GeoEduLab/Slinky-Seismometer/images/SlinkyRender1.PNG

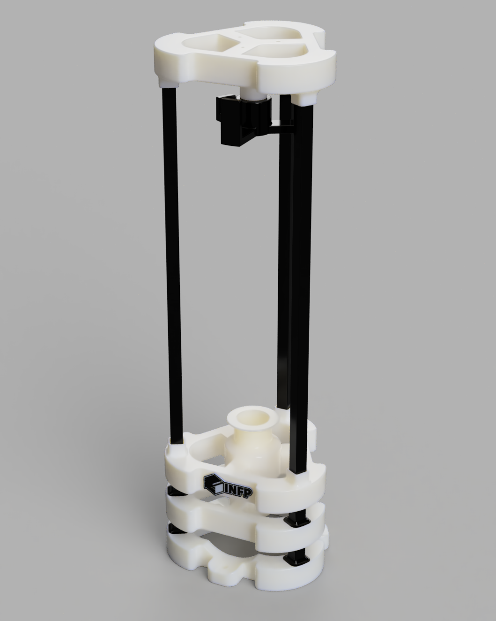
images/SlinkyRender1.PNG
