GeoEduLab/Slinky-Seismometer/3d_print_objs/Logo.obj

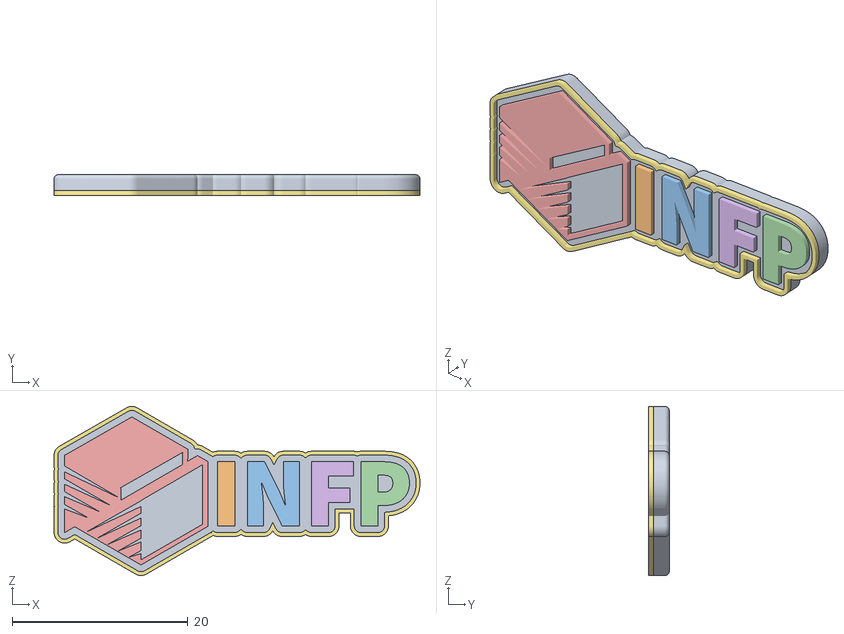
[picture p10: CAD file, 2026-05-05]
3d_print_objs/Logo.obj
41.6 x 2.36 x 19.2
