GeoEduLab/Slinky-Seismometer/3d_print_objs/BottomRing.obj

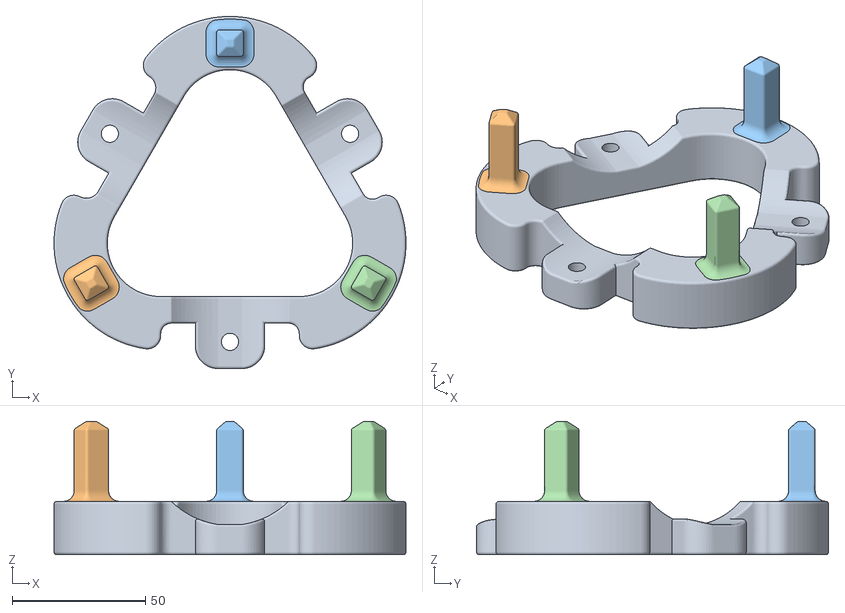
[picture p11: CAD file, 2026-05-05]
3d_print_objs/BottomRing.obj
132.0 x 132.0 x 50.0
