GeoEduLab/Slinky-Seismometer/3d_print_objs/DampenerRing.obj

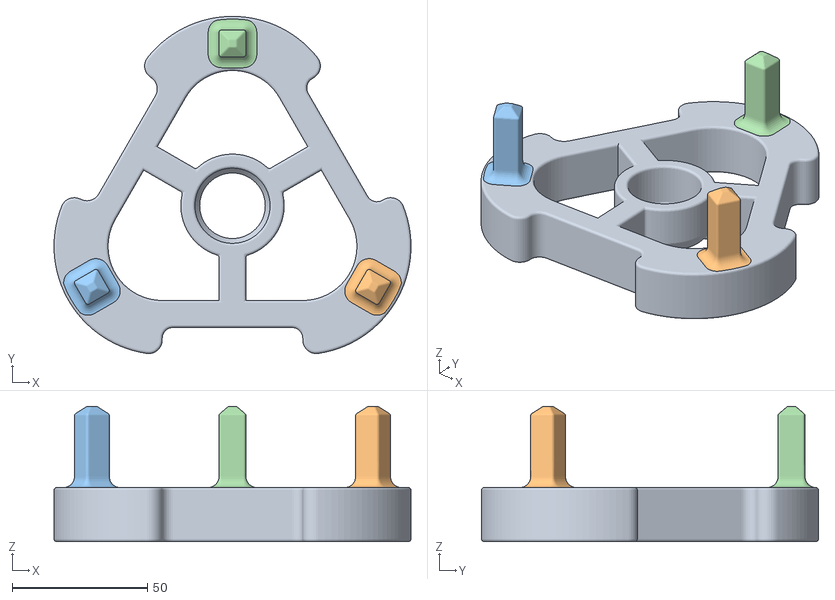
[picture p12: CAD file, 2026-05-05]
3d_print_objs/DampenerRing.obj
132.0 x 124.6 x 50.0
