GeoEduLab/Slinky-Seismometer/3d_print_objs/Rod.obj

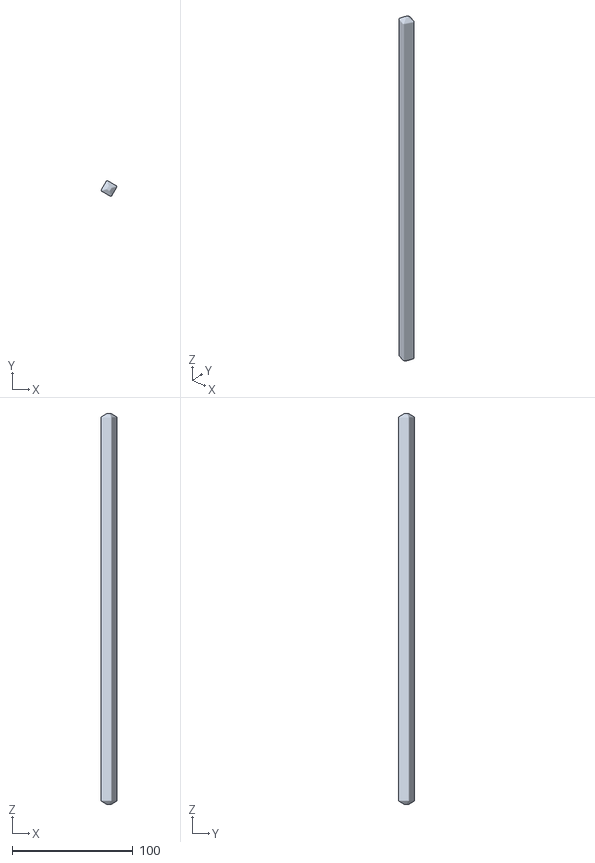
[picture p13: CAD file, 2026-05-05]
3d_print_objs/Rod.obj
12.9 x 12.9 x 323.2
