GeoEduLab/Slinky-Seismometer/3d_print_objs/JigBobinare.obj

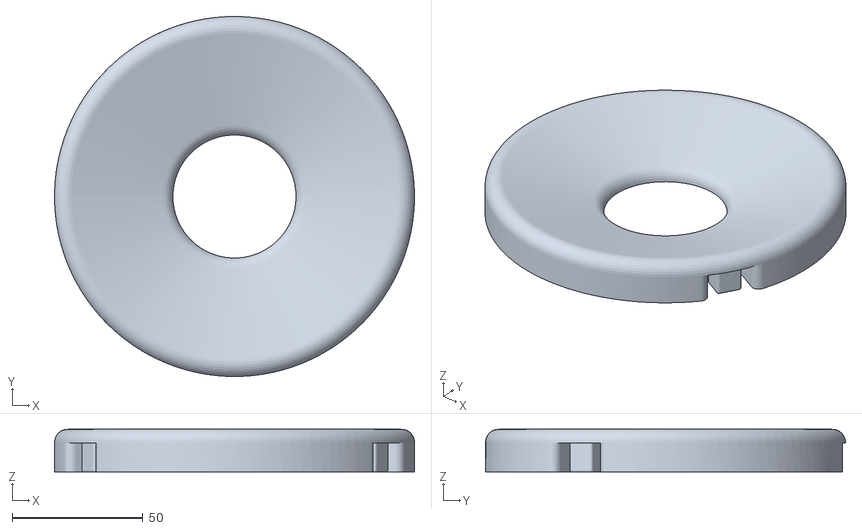
[picture p14: CAD file, 2026-05-05]
3d_print_objs/JigBobinare.obj
137.5 x 137.5 x 16.2
