GeoEduLab/Slinky-Seismometer/3d_print_objs/CoilRing.obj

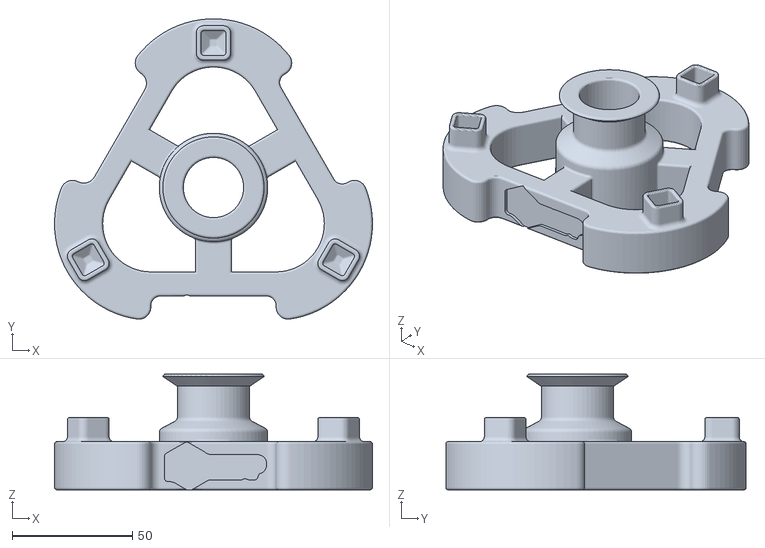
[picture p15: CAD file, 2026-05-05]
3d_print_objs/CoilRing.obj
132.0 x 124.6 x 48.0
