GeoEduLab/Slinky-Seismometer/3d_print_objs/FeetThumb.obj

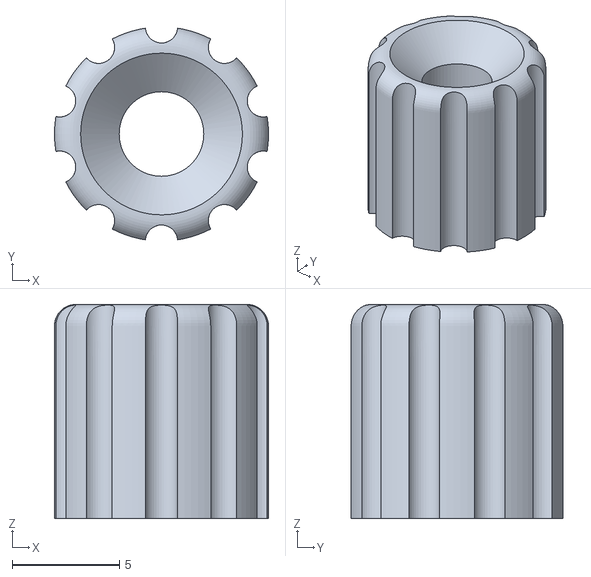
[picture p16: CAD file, 2026-05-05]
3d_print_objs/FeetThumb.obj
9.99 x 9.89 x 10.0
