GeoEduLab/Slinky-Seismometer/3d_print_objs/FeetTip.obj

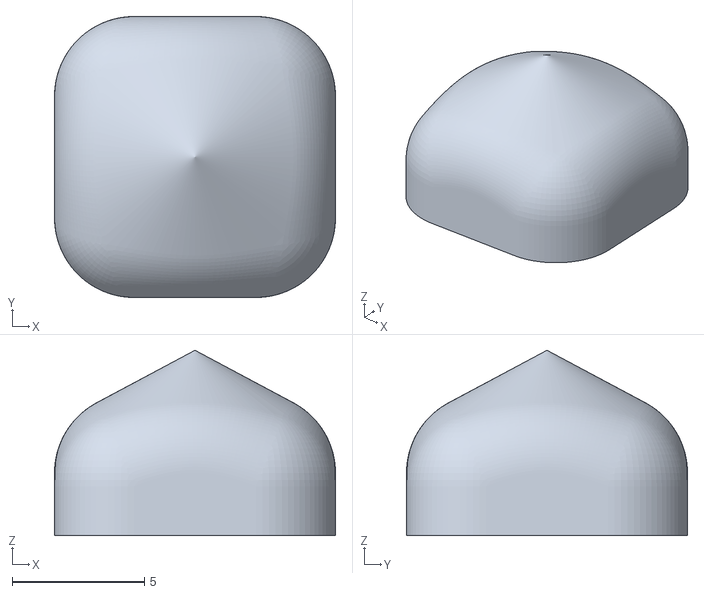
[picture p17: CAD file, 2026-05-05]
3d_print_objs/FeetTip.obj
10.6 x 10.6 x 7.00
