GeoEduLab/Slinky-Seismometer/3d_print_objs/MagnetHolder.obj

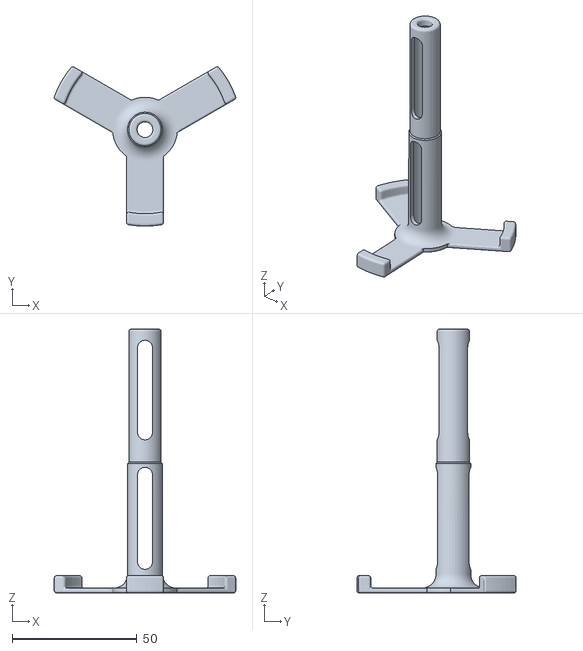
[picture p18: CAD file, 2026-05-05]
3d_print_objs/MagnetHolder.obj
72.9 x 64.0 x 106.0
