GeoEduLab/Slinky-Seismometer/3d_print_objs/SlinkyHolder.obj

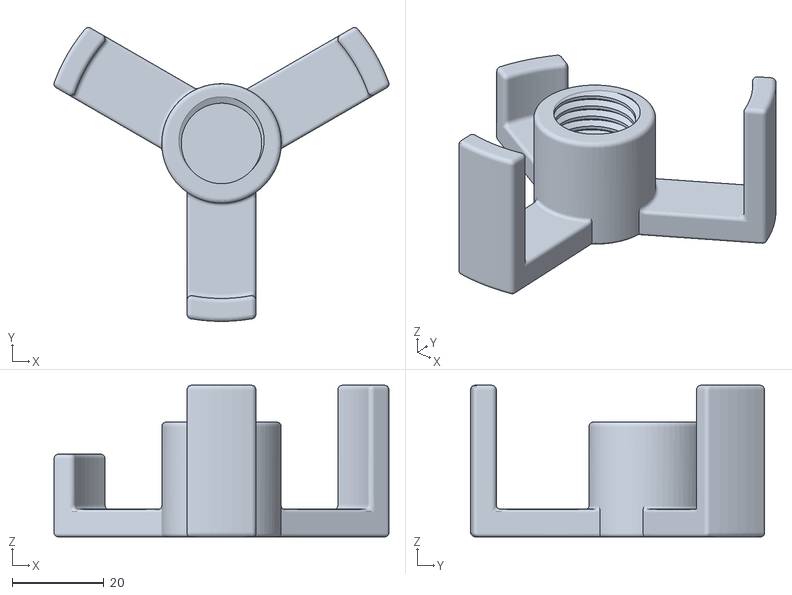
[picture p19: CAD file, 2026-05-05]
3d_print_objs/SlinkyHolder.obj
72.9 x 64.0 x 33.0
