GeoEduLab/Slinky-Seismometer/images/cover.jpg

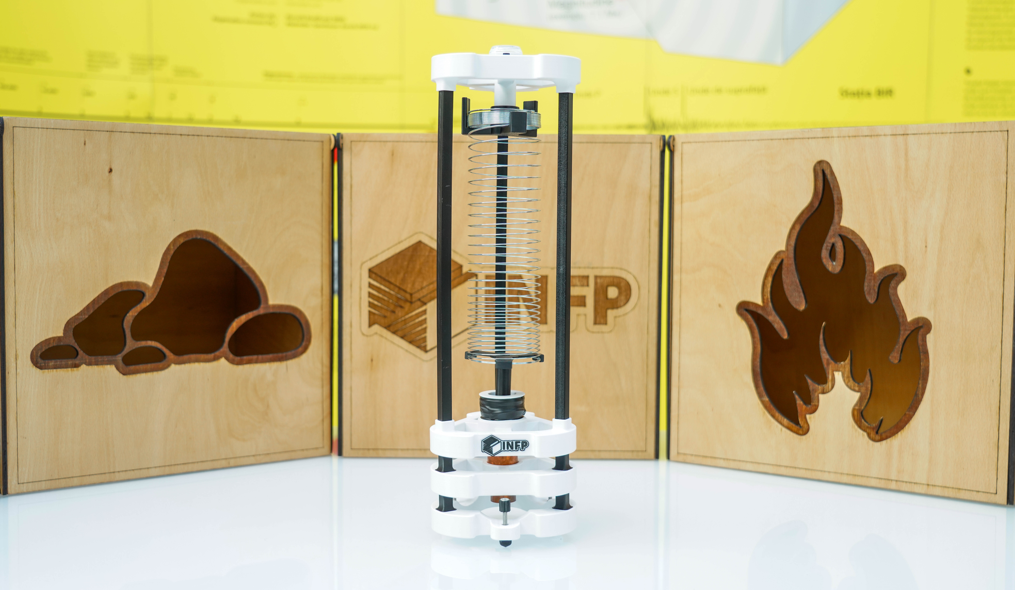
[picture p1: images/cover.jpg]
images/cover.jpg
